MOSH-Insa-Toulouse/2024-2025-4GP-Glubulax-TTRollanDD/Photos/C4-1u.PNG

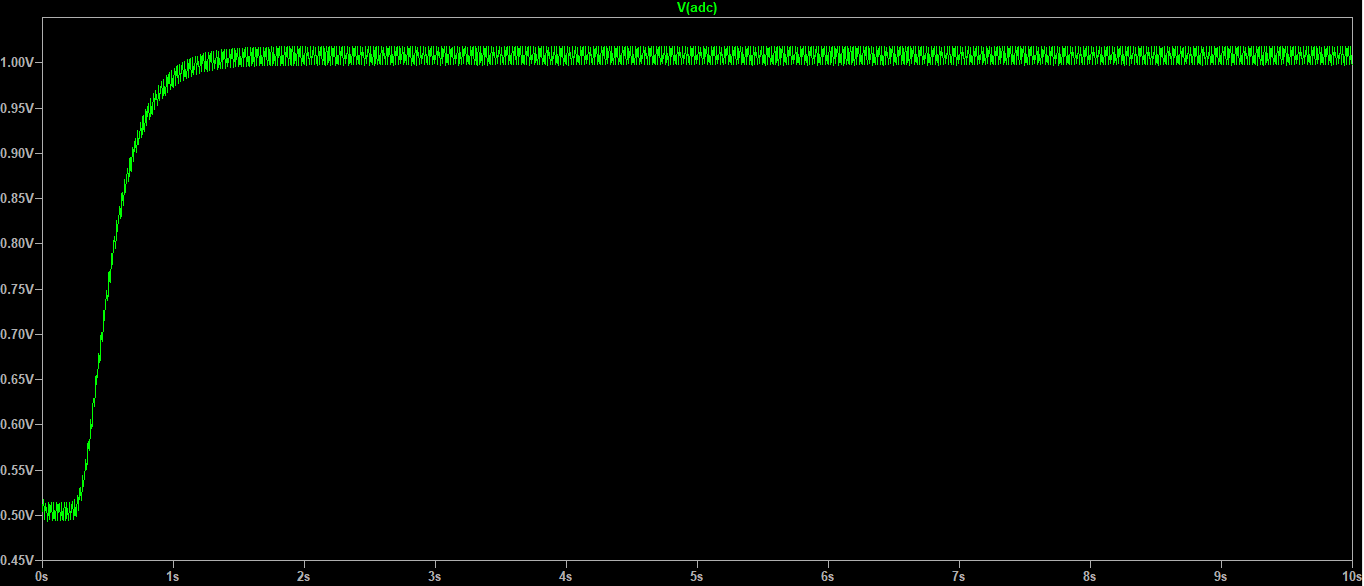
Photos/C4-1u.PNG
