MOSH-Insa-Toulouse/2024-2025-4GP-Glubulax-TTRollanDD/Photos/C4-100n.PNG

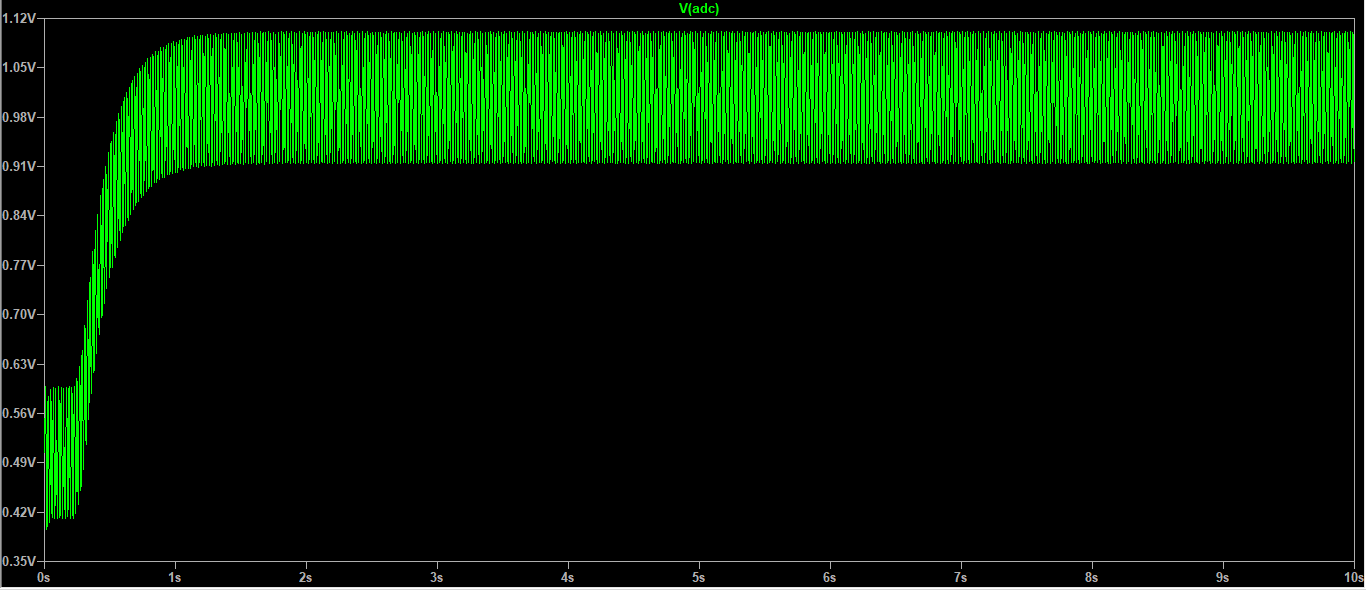
Photos/C4-100n.PNG
