MOSH-Insa-Toulouse/2024-2025-4GP-Glubulax-TTRollanDD/Photos/deltaR_12500_compression.PNG

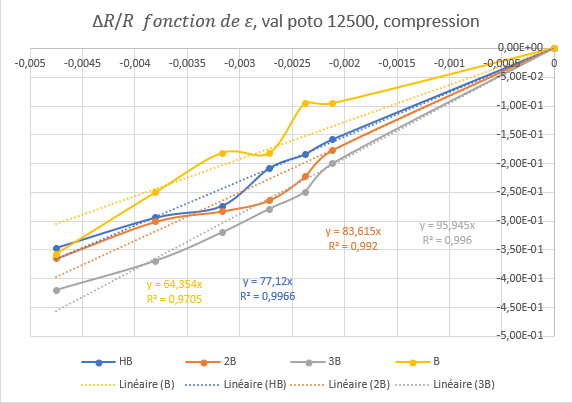
Photos/deltaR_12500_compression.PNG
