MOSH-Insa-Toulouse/2024-2025-4GP-Glubulax-TTRollanDD/Photos/deltaR_25000_flexion.PNG

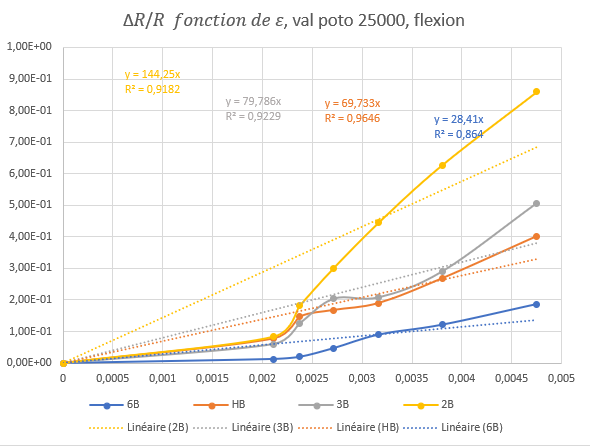
Photos/deltaR_25000_flexion.PNG
