MOSH-Insa-Toulouse/2024-2025-4GP-Glubulax-TTRollanDD/Photos/quantité-graphène.PNG

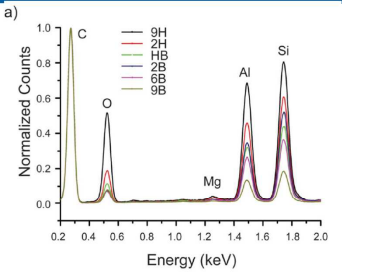
Photos/quantité-graphène.PNG
