MOSH-Insa-Toulouse/2024-2025-4GP-Glubulax-TTRollanDD/Photos/R_12500_compression.PNG

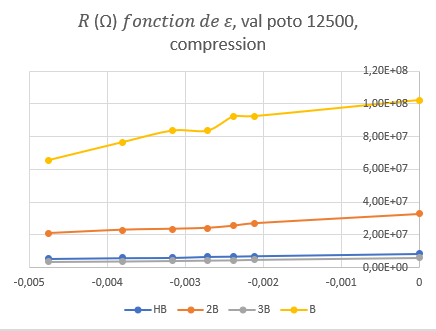
Photos/R_12500_compression.PNG
