MOSH-Insa-Toulouse/2024-2025-4GP-Glubulax-TTRollanDD/Photos/R_25000_flexion.PNG

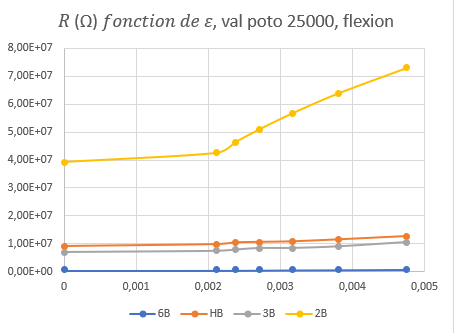
Photos/R_25000_flexion.PNG
