MOSH-Insa-Toulouse/2024-2025-4GP-Glubulax-TTRollanDD/Photos/résultats.PNG

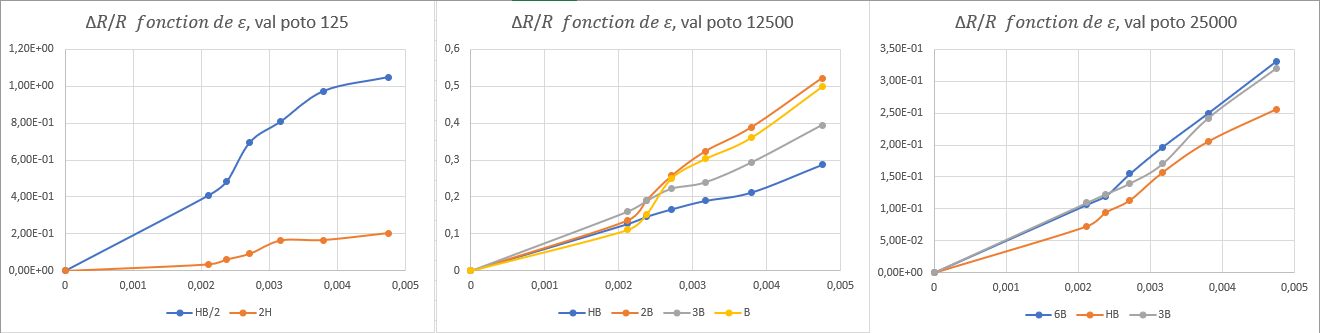
Photos/résultats.PNG
