MOSH-Insa-Toulouse/2024-2025-4GP-Glubulax-TTRollanDD/Photos/type-de-crayon.PNG

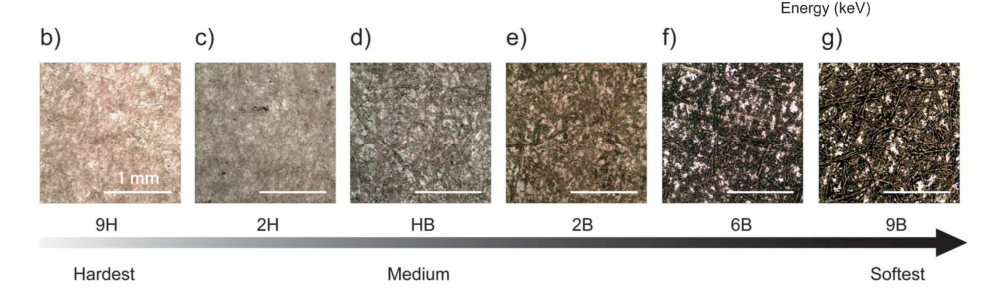
Photos/type-de-crayon.PNG
