MOSH-Insa-Toulouse/2024-2025-4GP-Glubulax-TTRollanDD/Résultats/capteur_HB_utilisé.PNG

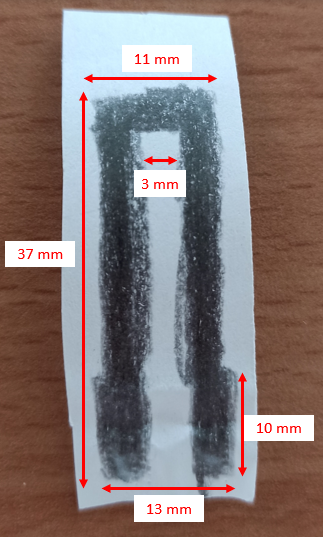
Résultats/capteur_HB_utilisé.PNG
