MOSH-Insa-Toulouse/2024-2025-4GP-Glubulax-TTRollanDD/Résultats/Outils_courbure.jpg

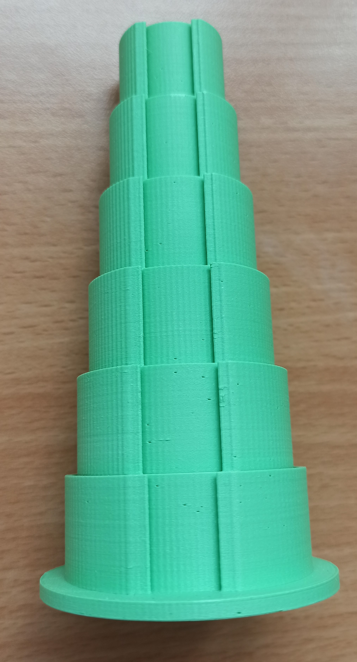
Résultats/Outils_courbure.jpg
