MOSH-Insa-Toulouse/2024-2025-4GP-Glubulax-TTRollanDD/Kicad arduino uno/Modèle 3D/FS-L-0095-103-ST - Assembly.stp

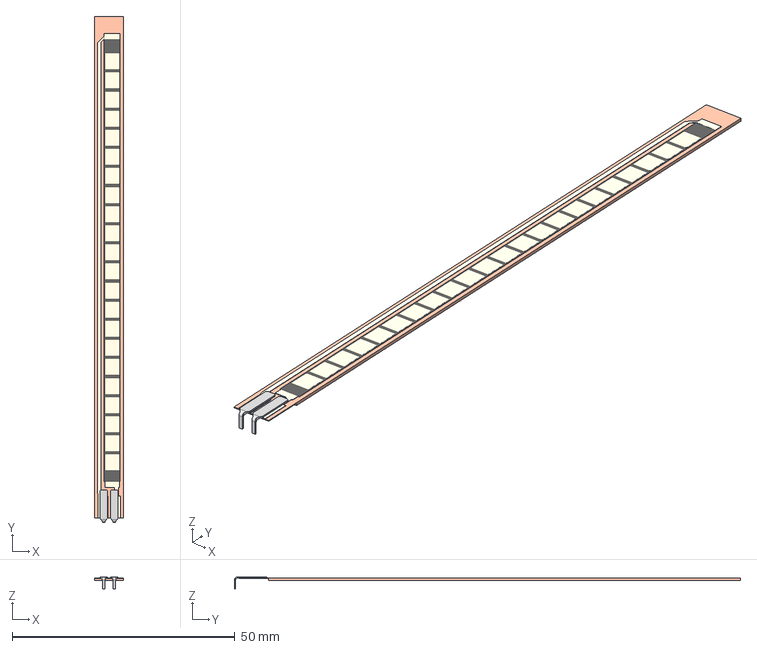
[picture p33: CAD file, 2025-03-13]
Kicad arduino uno/Modèle 3D/FS-L-0095-103-ST - Assembly.stp
6.45 x 113.5 x 2.77 mm
FS-L-0095-103-ST - Base
FS-L-0095-103-ST - Top
