MOSH-Insa-Toulouse/2024-2025-4GP-Glubulax-TTRollanDD/Kicad arduino uno/Modèle 3D/0.96 OLED v3.step

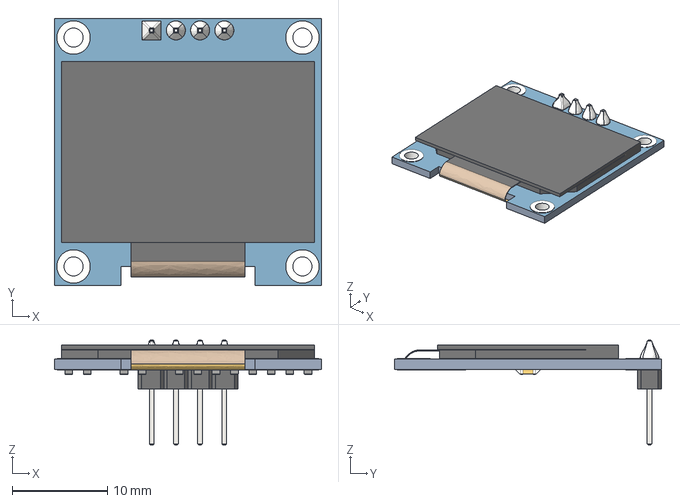
[picture p35: CAD file, 2025-03-13]
Kicad arduino uno/Modèle 3D/0.96 OLED v3.step
28.0 x 28.0 x 11.0 mm
