MOSH-Insa-Toulouse/2024-2025-4GP-Glubulax-TTRollanDD/Kicad arduino uno/Modèle 3D/rotary+encoder_14mm_hole_spc.stp

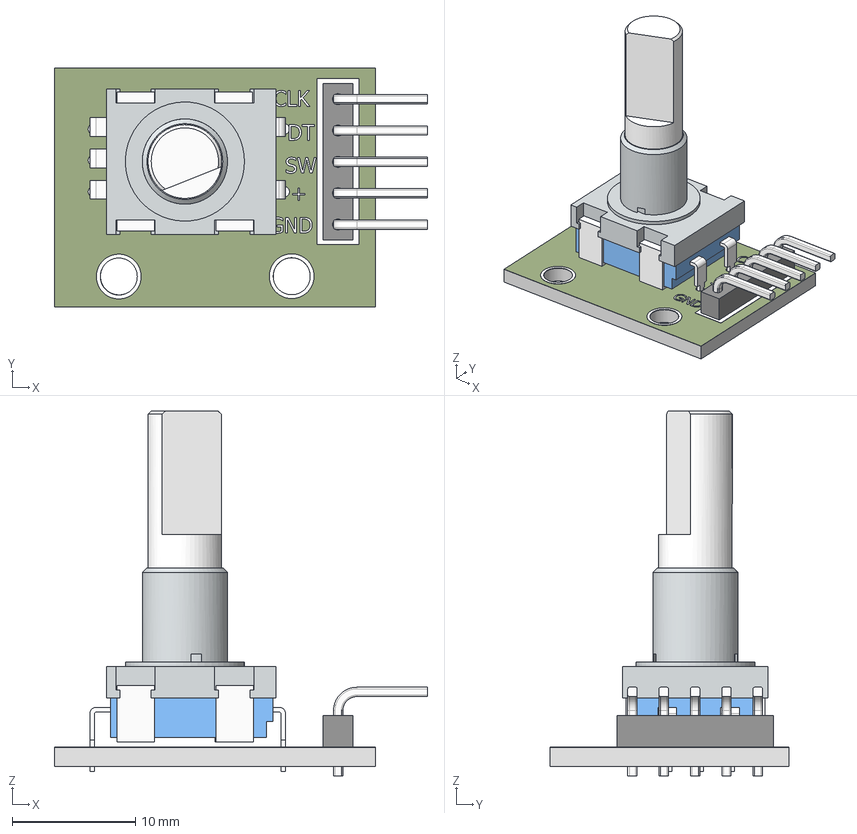
[picture p36: CAD file, 2025-03-13]
Kicad arduino uno/Modèle 3D/rotary+encoder_14mm_hole_spc.stp
30.2 x 19.3 x 29.6 mm
pcb
mtg flange
body_encoder
5 pin header
90d pin_header x 5
decal_encoder
pins_encoder body_2 x 5
shaft_encoder
