MOSH-Insa-Toulouse/2024-2025-4GP-Glubulax-TTRollanDD/Kicad arduino uno/Gerber/Capteur_graphite-B_Cu.pdf

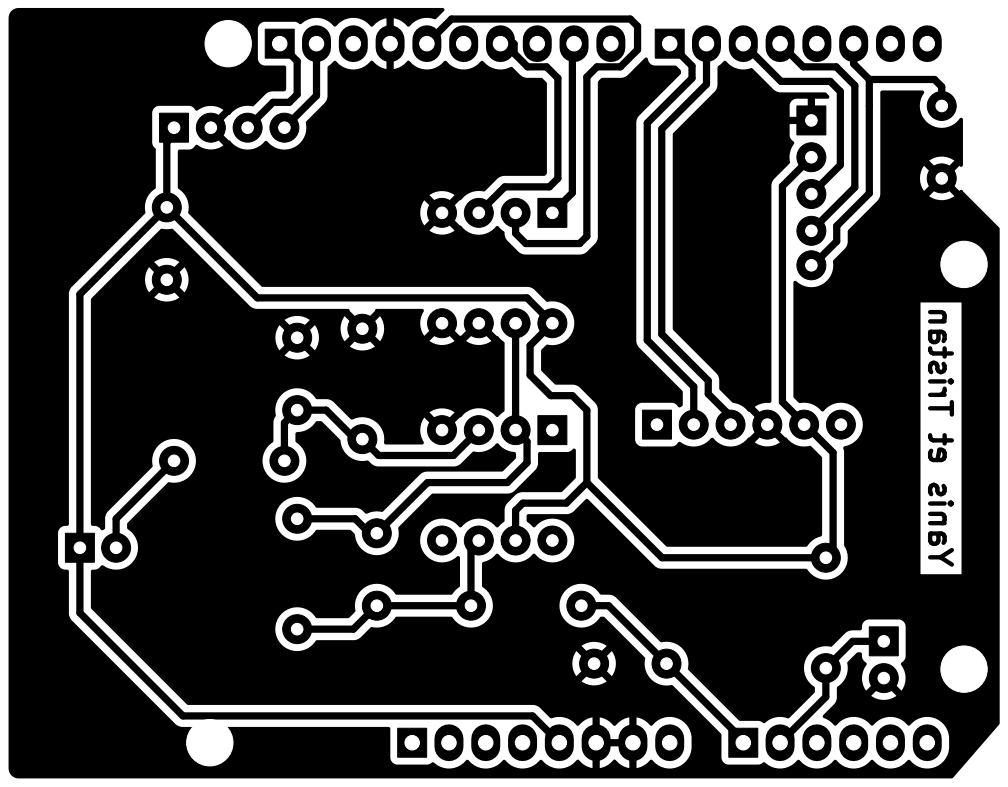
[picture p37: page 1]
