MOSH-Insa-Toulouse/2024-2025-4GP-Glubulax-TTRollanDD/LTspice/Tp_prise_en_main_Lt_spice/montage_tp3.asc

C1: cap; 20n
C2: cap; 220n
C3: polcap; 100µ
C4: cap; 47n
C5: polcap; 1µ
C6: polcap; 47µ
C7: cap; 20n
C8: cap; 100p
J1: njf; 2N4416
Q1: npn; 2N2222
Q2: npn; 2N2222
R1: res; 47
R2: res; 4.7
R3: res; 100k
R4: res; 1.5k
R5: res; 560k
R6: res; 4.7k
R7: res; 220k
R8: res; 68k
R9: res; 220
R10: res; 1k
R11: res; 220k
R12: res; 390
R13: res; 390
R14: res; 1.5k
R15: res; 100k
R16: res; 120k
R17: res; 4.7
R18: res; 2.4
R19: res; 80.6k
R20: res; 4.7k
U1: OP27
V1: voltage; SINE(0 1 10k); AC 1 0
V2: voltage; 15
V3: voltage; -15
Named nets: 0, entrée, out, sortie, filtre_out, V+, V-
.ac dec 1000 10 10meg
;noise V (filtre_out) V1 dec 1000 10 1meg
