MOSH-Insa-Toulouse/2024-2025-4GP-Glubulax-TTRollanDD/LTspice/Ampli_transimpédance/Ampli_transimpédance.asc

C1: cap; 100n
C2: cap; 0.1µ
C3: cap; 100n
C5: cap; 1p
R1: res; 10k
R2: res; 100k
R3: res; 1k
R4: res; 100k
R5: res; 1k
U1: LTC1050
V1: voltage; PULSE(0 1 0.2 0.1 0.1 20)
V2: voltage; 5
V3: voltage; SINE(0 325 50)
X1: capteur_graphène
Named nets: 0, ADC, +5V, Vem, Vep
.tran 2
