MOSH-Insa-Toulouse/2024-2025-4GP-Glubulax-TTRollanDD/LTspice/Ampli_transimpédance/capteur_graphène.asc

B1: bi; I=V(cp,cn)*(10n+V(gc,gn)*10n)
C1: cap; 200µ
R1: res; 1k
Named nets: cp, cn, gp, gn, gc
