MOSH-Insa-Toulouse/2024-2025-4GP-Glubulax-TTRollanDD/LTspice/Tp_prise_en_main_Lt_spice/filtre.asc

C1: cap; 20n
C2: cap; 20n
C3: cap; 100p
R1: res; 120k
R2: res; 4.7
R3: res; 2.4
R4: res; 80.6k
R5: res; 4.7k
U1: OP27
V1: voltage; SINE(0 140u 10k); AC 140u 0
V2: voltage; 15
V3: voltage; -15
Named nets: 0, filtre_out, out, input, V+, V-
