MOSH-Insa-Toulouse/2024-2025-4GP-Glubulax-TTRollanDD/LTspice/Tp_prise_en_main_Lt_spice/premier_circuit_q1a7.asc

C1: cap; 20n
C2: cap; 20n
C3: cap; 100p
R1: res; {mc(120k,tola)}
R2: res; 4.7
R3: res; {mc(2.2,tolb)}
R4: res; 80.6k
R5: res; 4.7k
U1: OP27
V1: voltage; 15
V2: voltage; 15
V3: voltage; SINE(0 1 10k 0.1m); AC 1 0; Rser=1
Named nets: 0, sortie1, sortie2, entrée
;dc dec V1 9K 12K
;.step param R 1 3 0.2
.op
.ac lin 1000 9k 11k
;tran 0 5ms 3m 0.1m
.param tola=0.01
.param tolb=0.05
.step param run 1 10 1
