MOSH-Insa-Toulouse/2024-2025-4GP-Glubulax-TTRollanDD/Kicad arduino uno/Capteur_graphite/Capteur_graphite.kicad_pcb

## KiCad design Kicad arduino uno/Capteur_graphite/Capteur_graphite.kicad_pcb (2025-03-28)

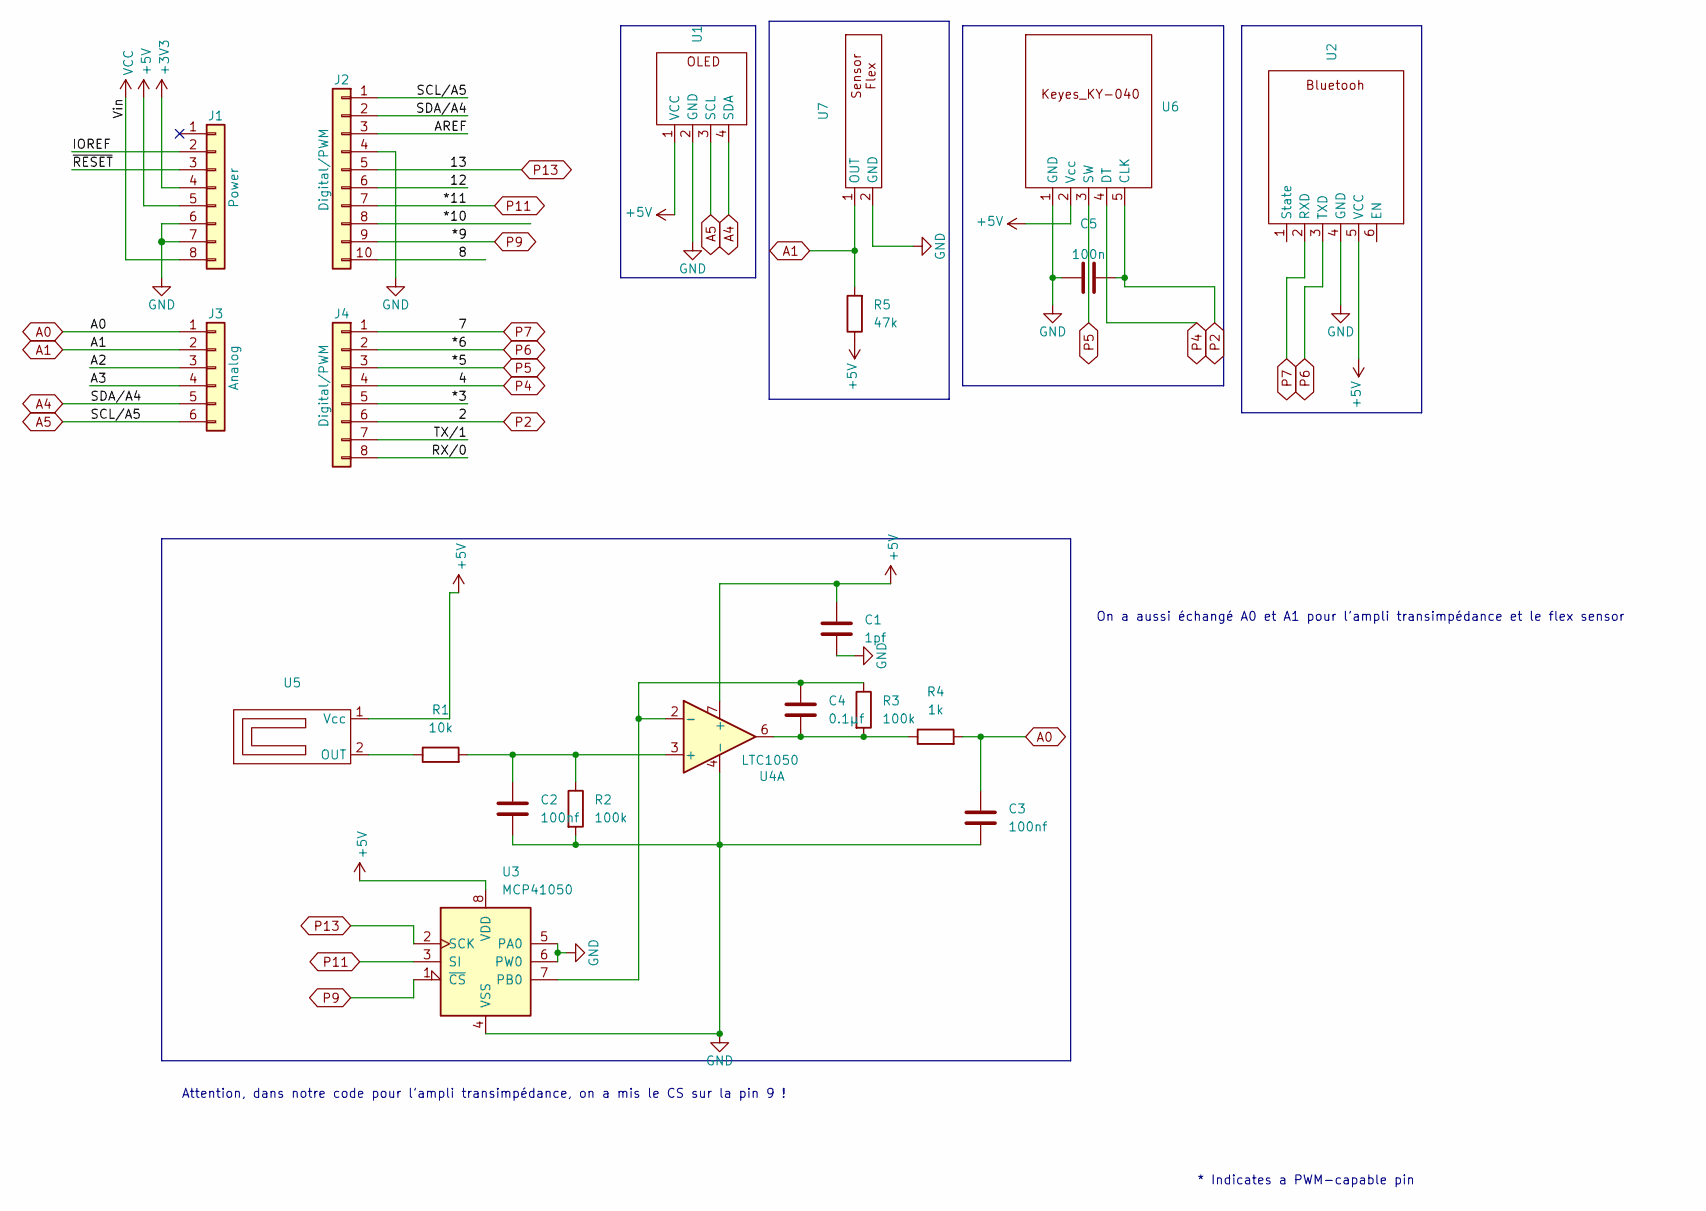
[picture p38: schematic Capteur_graphite.kicad_sch]

Parts:
C1: 1pf; C_Disc_D7.0mm_W2.5mm_P5.00mm
C2, C3: 100nf; C_Disc_D7.0mm_W2.5mm_P5.00mm
C4: 0.1µf; C_Disc_D7.0mm_W2.5mm_P5.00mm
C5: 100n; C_Disc_D7.0mm_W2.5mm_P5.00mm
J1: Power; PinSocket_1x08_P2.54mm_Vertical
J2: Digital/PWM; PinSocket_1x10_P2.54mm_Vertical
J3: Analog; PinSocket_1x06_P2.54mm_Vertical
J4: Digital/PWM; PinSocket_1x08_P2.54mm_Vertical
R1: 10k; R_Axial_DIN0204_L3.6mm_D1.6mm_P7.62mm_Horizontal
R2, R3: 100k; R_Axial_DIN0204_L3.6mm_D1.6mm_P7.62mm_Horizontal
R4: 1k; R_Axial_DIN0204_L3.6mm_D1.6mm_P7.62mm_Horizontal
R5: 47k; R_Axial_DIN0204_L3.6mm_D1.6mm_P7.62mm_Horizontal
U1: OLED
U2: BLUETOOTH
U3: MCP41050
U4: LTC1050
U5: Capteur
U6: Keyes KY_040
U7: Flex

Connections:
+3V3: J1.4
+5V: C1.1, J1.5, R5.1, U1.1 (VCC), U2.5 (VCC), U3.8 (VDD), U4.7 (+), U5.1 (Vcc), U6.2 (Vcc)
/8: J2.10
/12: J2.6
/*3: J4.5
/*10: J2.8
/A2: J3.3
/A3: J3.4
/AREF: J2.3
/IOREF: J1.2
/RX/0: J4.8
/TX/1: J4.7
/~RESET: J1.3
A0: C3.2, J3.1, R4.2
A1: J3.2, R5.2, U7.1 (OUT)
A4: J2.2, J3.5, U1.4 (SDA)
A5: J2.1, J3.6, U1.3 (SCL)
GND: C1.2, C2.1, C3.1, C5.1, J1.6, J1.7, J2.4, R2.2, U1.2 (GND), U2.4 (GND), U3.4 (VSS), U3.5 (PA0), U3.6 (PW0), U4.4 (-), U6.1 (GND), U7.2 (GND)
unnamed: C2.2, R1.2, R2.1, U4.3 (+)
unnamed: C4.1, R3.2, R4.1, U4.6
unnamed: C4.2, R3.1, U3.7 (PB0), U4.2 (-)
unnamed: R1.1, U5.2 (OUT)
P2: C5.2, J4.6, U6.5 (CLK)
P4: J4.4, U6.4 (DT)
P5: J4.3, U6.3 (SW)
P6: J4.2, U2.3 (TXD)
P7: J4.1, U2.2 (RXD)
P9: J2.9, U3.1 (~CS)
P11: J2.7, U3.3 (SI)
P13: J2.5, U3.2 (SCK)
VCC: J1.8

Notes on the sheet:
Attention, dans notre code pour l'ampli transimpédance, on a mis le CS sur la pin 9 !
On a aussi échangé A0 et A1 pour l'ampli transimpédance et le flex sensor
* Indicates a PWM-capable pin

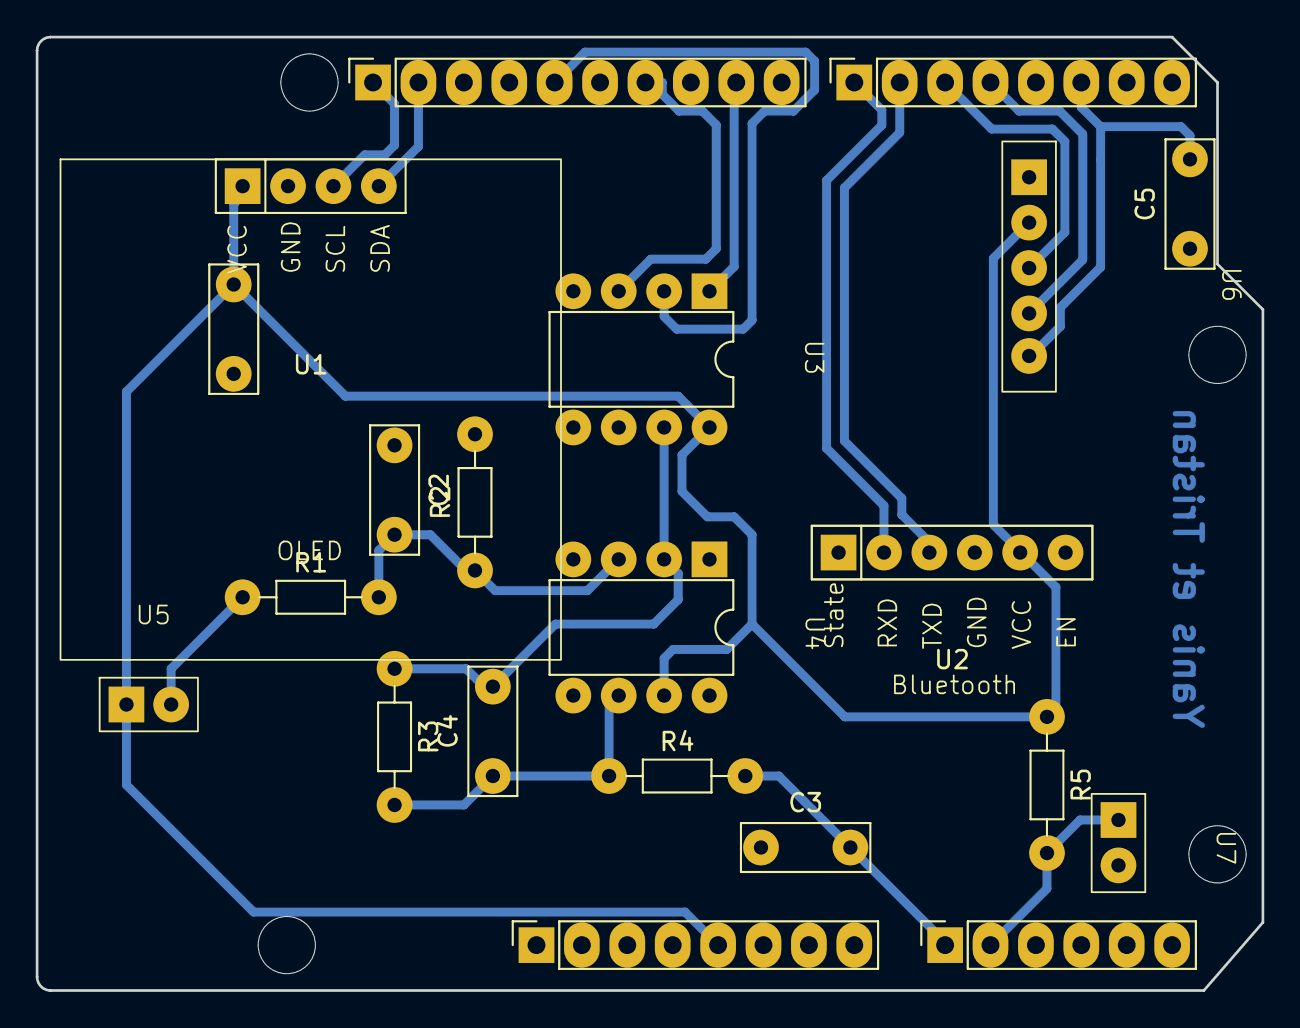
[picture p39: board Capteur_graphite.kicad_pcb from above]

Board: 2 copper layers, 68.6 x 53.3 mm, 25 parts (0 on the bottom side), 18 nets.

Other parts of the board:
MH1, MH2, MH3, MH4: MountingHole_3.2mm
