MOSH-Insa-Toulouse/2024-2025-4GP-Glubulax-TTRollanDD/(commit log)

2025-02-19 Ajout de la toDo liste
2025-02-19 je change la ligne 7
2025-03-13 ajout Ltspice + tp_Mosh + Kicad
    [0.96 OLED v3.step, Capteur_graphite.kicad_pcb, Capteur_graphite.kicad_sch, DIP-8 W7.62mm IC with Socket.stp, FS-L-0095-103-ST - Assembly.stp, KiCad-Shield-Uno-FlexSensor.kicad_pcb, KiCad-Shield-Uno-FlexSensor.kicad_sch, rotary+encoder_14mm_hole_spc.stp]
2025-03-13 masse flottante à refaire
    [Capteur_graphite.kicad_pcb, Capteur_graphite.kicad_sch]
2025-03-19 pcb_verifiée_et_pin_size_modifiée
    [Capteur_graphite.kicad_pcb]
2025-03-19 pcb_verifiée_prêt_à_percer
    [Capteur_graphite.kicad_pcb]
2025-03-19 soucis_drill_invisible_rectifié
    [Capteur_graphite.kicad_pcb]
2025-04-12 Résultats_complets
    [Mesures.xlsx]
2025-04-23 Add the good ones
    [Mesures.xlsx]
2025-04-23 Add results
    [Mesures.xlsx]
2025-04-29 Modif mesure
    [Mesures.xlsx]
