MOSH-Insa-Toulouse/2024-2025-4GP-Glubulax-TTRollanDD/Photos/Résultat_final1.jpg

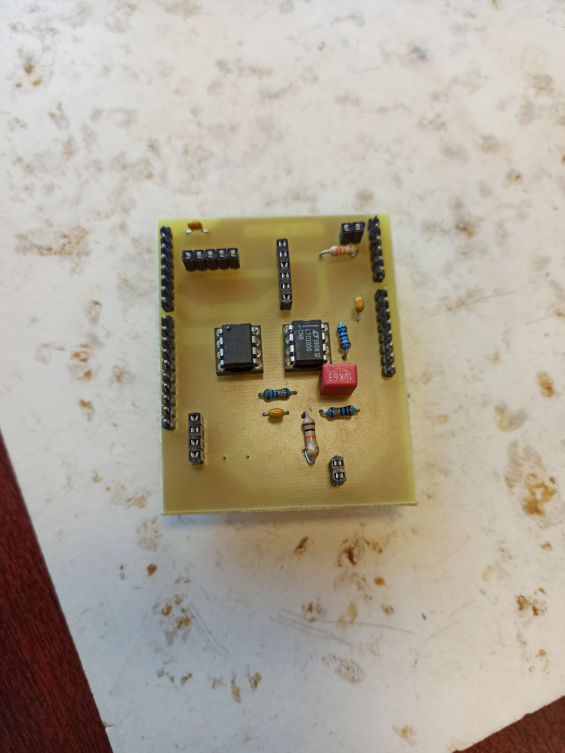
[picture p11: Photos/Résultat_final1.jpg]
Photos/Résultat_final1.jpg
