MOSH-Insa-Toulouse/2024-2025-4GP-Glubulax-TTRollanDD/Photos/Résultat_final2.jpg

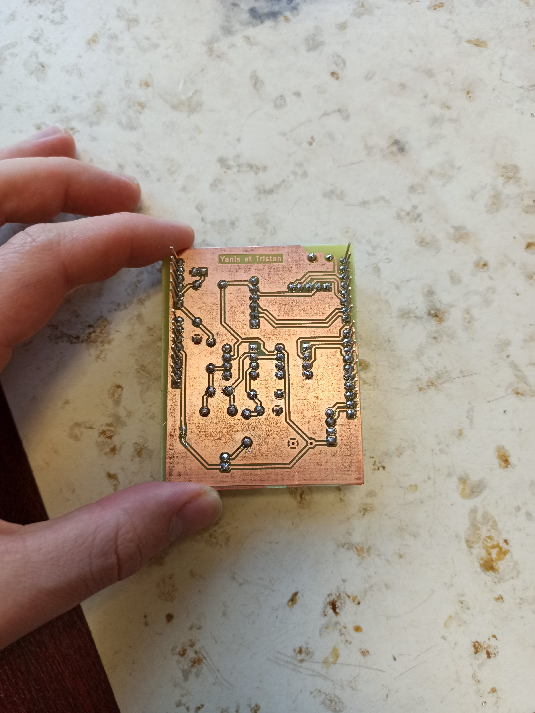
[picture p12: Photos/Résultat_final2.jpg]
Photos/Résultat_final2.jpg
